hrantarzuman/DC2DC_UPS-for-network/(commit log)

2026-09-08 İlk commit: modem+Pi için DIY DC-UPS projesi (mimari, BOM, Arduino izleme firmware'i)
    4 açık kaynak DC-UPS reposu (TobleMiner/DC-UPS, dilshan/12v-automatic-ups,
    issus/UninterruptableDCPowerSupply12V, 8bitmcu/mcuups) incelenip, kanıtlanmış
    switchover mantığından esinlenen ama Arduino+LiFePO4+Schottky ORing ile
    sadeleştirilmiş bir sentez mimari tasarlandı. Hedef: Keenetic Hero modem +
    Raspberry Pi CM5'i kesintide en az 4 saat ayakta tutmak.
2026-09-08 Kontrolcüyü Arduino Nano yerine ESP32-C3 Mini'ye taşı, doğrudan Telegram bildirimi ekle
    Hrant'ta zaten mevcut ESP32-C3 Mini ve Arduino Uno kullanılabilir mi sorusu üzerine
    ESP32-C3 tercih edildi: Wi-Fi'si sayesinde UPS artık mains-kaybı/düşük-batarya
    bildirimini Pi'nin ayakta olmasına bağımlı olmadan doğrudan Telegram'a gönderebiliyor.
    - Gerilim bölücüler 3.3V ADC tavanına göre yeniden hesaplandı (AC: 100k+10k, Bat: 47k+10k)
    - Pin seçimi ESP32-C3'ün boot-strapping pinlerinden (GPIO2/8/9) kaçınacak şekilde yapıldı
    - secrets.h.example + .gitignore eklendi (Wi-Fi/Telegram bilgileri asla commit edilmez)
    - BOM güncellendi: Arduino Nano satırı kaldırıldı, ESP3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
2026-09-08 BOM: Pi için step-down modül olarak Kaplantis QCmini seçildi
    Giriş 6-32V, çıkış varsayılan 5V (24W = ~4.8A'ya kadar) — Pi hiçbir QC
    negotiation'ı tetiklemediğinden hep sabit 5V üretir, QC2.0/3.0 IC farkı
    bu kullanım için önemsiz. USB-A çıkışlı; mevcut Baseus USB-A→USB-C kablo
    ile Pi'ye bağlanacak, ayrı kablo alınmasına gerek yok.
2026-09-08 BOM: ESP32-C3 için de aynı Kaplantis QCmini modülünden ikinci adet kullan
    Tek parça numarasıyla hem Pi hem ESP32-C3 beslenecek (2 adet QCmini,
    bağımsız hatlar). ESP32-C3 tarafı kalıcı montajda kablo yerine doğrudan
    5V/GND pedinden lehimlenecek.
2026-09-08 Kurşun asit aküye geçiş, ORing'i tek diyota sadeleştir, bağlantı şeması ekle
    - Batarya LiFePO4'ten Power-Xtra PX26-12 (12V 26Ah VRLA kurşun asit)'e
    değiştirildi — maliyet çok daha uygun, ~%50 DoD ile 4 saat hedefi karşılanıyor.
    - Şema çizilirken ikinci ORing diyotunun gereksiz olduğu anlaşıldı: akü ile
    ortak bara zaten aynı düğüm (klasik float-şarj topolojisi), sadece şarj
    modülü ile bara arasında TEK diyot (D1, 1N5822) yeterli.
    - Şarj voltajı LiFePO4'ün 14.6V'u yerine akünün float değerine (13.6-13.8V)
    ayarlanacak şekilde güncellendi.
    - Firmware'deki SOC tablosu kurşun asit voltaj eğrisine göre yeniden
    kalibre edildi, SOC_LOW_THRESHOLD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
2026-09-08 2 renkli (kırmızı/yeşil) LED desteği ekle
    Hrant'ın elindeki 3 bacaklı ortak katot kırmızı/yeşil LED kullanılacak
    (tek renkli LED yerine). GPIO6=yeşil (AC_OK), GPIO7=kırmızı (batarya/düşük
    batarya, yanıp sönme hızıyla ayrışıyor). Ortak anot ihtimaline karşı
    firmware'de LED_ON/LED_OFF sabitleri ve kod içi doğrulama talimatı eklendi.
2026-09-08 Telegram /durum komutu ekle (getUpdates polling, kütüphanesiz)
    Firmware artık sadece durum değişikliğinde bildirim GÖNDERMİYOR, aynı
    zamanda Telegram'dan gelen mesajları da DİNLİYOR. "/durum" komutu anlık
    AC hattı/batarya voltajı ve yüzdesiyle yanıt veriyor, "/start" kısa bir
    kullanım notu döndürüyor. Boot'ta bekleyen eski komutlar (offset=-1 ile)
    sessizce temizleniyor, yeniden başlatmada gecikmeli yanıt gitmiyor.
    JSON ayrıştırması harici kütüphane olmadan basit string arama ile yapıldı.
2026-09-08 Gerilim bölücüleri gerçek multimetre ölçümüyle kalibre et, RAW_MV çıktısı ekle
    Serial çıktısına VAC_RAW_MV/VBAT_RAW_MV eklendi (kalibrasyon formülünü
    doğrudan uygulanabilir hale getirir). Multimetre referansı: adaptör 24.0V,
    akü mains varken 14.0V / yokken 13.6V. AC_DIVIDER_RATIO 11.0->9.83,
    BAT_DIVIDER_RATIO 5.7->5.07 olarak güncellendi.
2026-09-08 Akünün ilk şarjı tamamlandı, şarj modülü float'a (13.5V) çekildi
    Şarj akımı ~0.25A'ya düşünce (doldu eşiği) XL4015 çıkışı 14.4V bulk'tan
    13.5V standby/float değerine geçirildi (akünün etiketindeki 13.5-13.8V
    aralığının alt ucu). Akü kalıcı kuruluma hazır.
2026-09-09 SOC tablosunu üreticinin resmi 10.50V bitiş voltajına göre yeniden çapala, LOW alarm debounce ekle
    Power-Xtra PX26-12B datasheet incelendi: üretici voltaj->SOC tablosu
    yayınlamıyor ama resmi 20 saatlik deşarj bitiş voltajı (10.50V) veriyor —
    SOC_TABLE'ın 0% ucu artık buna dayanıyor (önceki 11.5V varsayımından
    daha isabetli), tablo genel olarak düzleştirildi.
    Gerçek testte görülen sorun: mains kesilir kesilmez akünün "surface
    charge"ı (yüzey şarjı) hızla dağıldığından voltaj birkaç dakika gerçekte
    olduğundan düşük görünüyor — bu ON_BATTERY_LOW'a anlık, gereksiz geçişe
    ve Telegram spam'ine yol açıyordu. ON_BATTERY<->ON_BATTERY_LOW geçişine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
2026-09-09 README: SOC tablosu düzeltmesini ve surface-charge bulgusunu belgelendir
2026-09-09 Refine BAT_DIVIDER_RATIO for accuracy
    hasas voltaj kalibrasyonu yapıldı 5.08427
2026-09-09 README: ESP32-C3 QCmini hattının izole kalması gerektiğini belgelendir
    9 Eylül 2026 yük testinde bir powerbank yanlışlıkla ESP32-C3'ün kendi
    QCmini'sine bağlandı, ESP32'nin 5V girişi sarkıp ADC referansını
    etkiledi (gürültü, ölçüm hatası — brown-out değil). Bu hattın sadece
    ESP32-C3 için kullanılması gerektiği, test yükleri dahil başka hiçbir
    şeyin paylaştırılmaması gerektiği not edildi.
2026-09-09 GPIO3 sarj-sense divider ve 128x64 I2C LCD deteği ekle
    - Ucuncu bolucu (sarj cikisi, diyottan once) GPIO2 yerine GPIO3'e
    baglandi -- GPIO2 boot-strapping pini oldugundan riskliydi.
    - 128x64 SSD1306 LCD icin I2C (GPIO10=SDA, GPIO20=SCL) eklendi,
    strapping/dahili-LED cakismasi olan GPIO8/9'dan kacinildi.
    - README: BOM, firmware notlari ve karar log'u guncellendi.
2026-09-09 Basarisiz Telegram bildirimlerini tekrar dene, LCD test notlarini ekle
    - sendTelegramMessage artik basari/basarisizlik donduruyor;
    notifyStateChangeIfNeeded basarisiz gonderimde durumu
    "bildirildi" olarak isaretlemiyor, 5sn'de bir basarana kadar
    tekrar deniyor. Onceki halde tek seferlik bir HTTPS/TLS
    aksakligi kritik bir bildirimi sessizce kaybedebiliyordu.
    - README: LCD donanim testi bulgulari ve bug fix notu eklendi.
    [ups_monitor_esp32c3.ino]
2026-09-09 Update CHG_DIVIDER_RATIO for calibration
    5.16623 değeri ile daha doğru voltaj değeri okunuyor
2026-09-09 README: LCD baglanmasinin WiFi'yi kilitledigi bulgusunu belgelendir
    LCD sokulunce WiFi aninda baglandi -- guc cekisi (TX aninda
    regulator cokmesi) ve/veya OLED boost devresinin EMI'si suphe
    altinda. Sonraki LCD denemesinde VCC/GND'ye kapasitor eklenmesi
    ve antenden fiziksel uzak tutulmasi notu duzuldu.
2026-09-09 I2C LCD pinlerini GPIO10/20'den GPIO4/5'e degistir (yeniden test)
    GPIO10/GPIO20 ile LCD baglandiginda WiFi hicbir aga baglanamaz
    hale geliyordu (guc cekisi/EMI supheli, bkz. README test notu).
    Baslangicta onerilen GPIO4=SDA/GPIO5=SCL ile tekrar deneniyor.
    [ups_monitor_esp32c3.ino]
2026-09-09 LCD entegrasyonunu kaldir, yerine WiFi HTTP durum sayfasi ekle
    LCD modulu arizali cikti ve bagliyken WiFi'yi tamamen kilitliyordu
    (guc cekisi/EMI supheli). LCD kodu ve Adafruit kutuphane bagimliligi
    tamamen kaldirildi. Yerine ESP32'nin kendi WiFi'si uzerinden,
    ek kutuphane gerektirmeyen WebServer tabanli basit bir HTTP durum
    sayfasi eklendi (http://<esp32-ip>/, 5sn'de bir otomatik yenilenir).
    [ups_monitor_esp32c3.ino]
2026-09-09 stateName() icin elle prototip ekleyerek derleme hatasini duzelt
    Arduino IDE .ino dosyalari icin fonksiyon prototiplerini otomatik
    olarak dosyanin basina (enum UpsState tanimindan once) ekliyor.
    stateName(UpsState s) bu enum'u parametre aldigindan otomatik
    prototip enum tanimlanmadan once olusup "UpsState was not
    declared in this scope" / "redeclared as different kind of
    entity" hatasi veriyordu. Dogru prototip enum'dan hemen sonra
    elle eklendi, Arduino kendi hatali prototipini atliyor artik.
2026-09-09 MIT lisansi, katkida bulunma notu ve ilham alinan projeler listesi ekle
    Repoyu baskalarinin kullanip gelistirmesi icin acik bir lisans
    ve katkida bulunma yonergesi eklendi. Projeye baslarken incelenen
    4 acik kaynak DC-UPS reposu (TobleMiner/DC-UPS, dilshan/12v-automatic-ups,
    issus/UninterruptableDCPowerSupply12V, 8bitmcu/mcuups) tesekkur
    notuyla listelendi.
2026-09-10 Web uzerinden kalibrasyon sayfasi ekle (NVS ile kalici, flas gerekmez)
    http://<esp32-ip>/kalibrasyon sayfasi eklendi: her hat (AC/BAT/CHG)
    icin ham mV, hesaplanan voltaj ve mevcut oran gosteriliyor;
    multimetreyle olculen gercek voltaj girilip kaydedilince oran
    otomatik hesaplanip Preferences (NVS) ile kalici hafizaya yaziliyor.
    Kodun icindeki DIVIDER_RATIO sabitleri artik sadece NVS bossa
    (ilk kurulum) kullanilan baslangic degerleri -- bundan sonraki
    kalibrasyonlar icin yeniden flas atmaya gerek yok.
2026-09-10 ArduinoOTA ile kablosuz (WiFi) firmware guncellemesi ekle
    Kart WiFi'ye baglandiktan sonra Arduino IDE'de Tools > Port
    altinda "UPS_ESP32C3 at <ip>" olarak goruyor, USB'ye gerek
    kalmadan oradan firmware yuklenebiliyor. Sifre secrets.h'deki
    yeni OTA_PASSWORD alanindan geliyor (secrets.h.example'a da
    eklendi). Ilk kurulum yine USB ile yapilmali, sonraki tum
    guncellemeler OTA ile yapilabilir.
2026-09-10 Kesinti gecmisini NVS'ye yaz, artik reset/OTA ile kaybolmuyor
    outageLog RAM-only'den NVS'ye (Preferences) tasindi -- OTA
    guncelleme veya herhangi bir ESP32 reseti onceden tum gecmisi
    siliyordu. Her kesinti bittiginde ~480 bayt'lik dizi + sayaclar
    NVS'ye yaziliyor, boot'ta geri okunuyor.
    [ups_monitor_esp32c3.ino]
2026-09-11 Faz 3 gercek yuk testi sonuclarini belgele (8 saat, %55 akü, hic reset yok)
    Modem+Pi CM5+HDD+alarm birlikte UPS'e baglanip fis cekme testi
    yapildi: SSH ile Pi'de surekli throttled=0x0, tek reset olmadi,
    modem de resetlenmedi, HDD erisilebilir kaldi. 8 saat sonunda
    akü hala %55 (12.11V) -- dogrusal uzatmayla teorik toplam
    runtime ~17-18 saat (4 saatlik hedefin cok uzerinde). Ekran
    goruntusu galeriye eklendi, "Sonraki Adimlar" ve "Durum"
    bolumleri guncellendi.
